LeonardoPoliti/eeg-cap-dryer/cad/cap_dryer.step

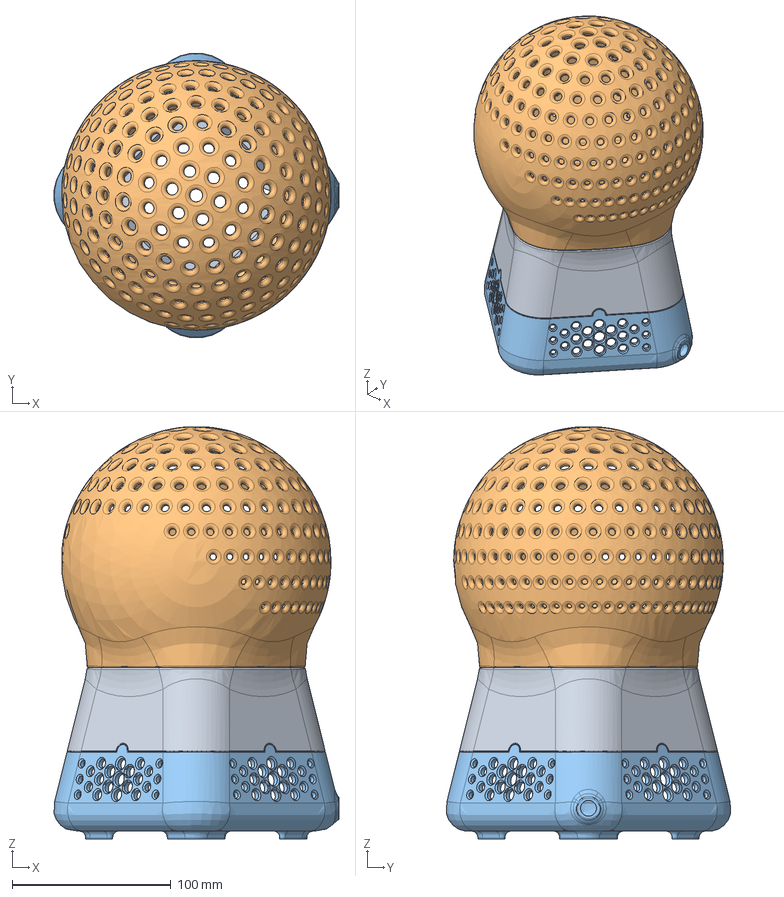
[picture p7: CAD file, 2026-10-29]
cad/cap_dryer.step
179.6 x 179.3 x 259.7 mm
