LeonardoPoliti/eeg-cap-dryer/stl/dome.stl

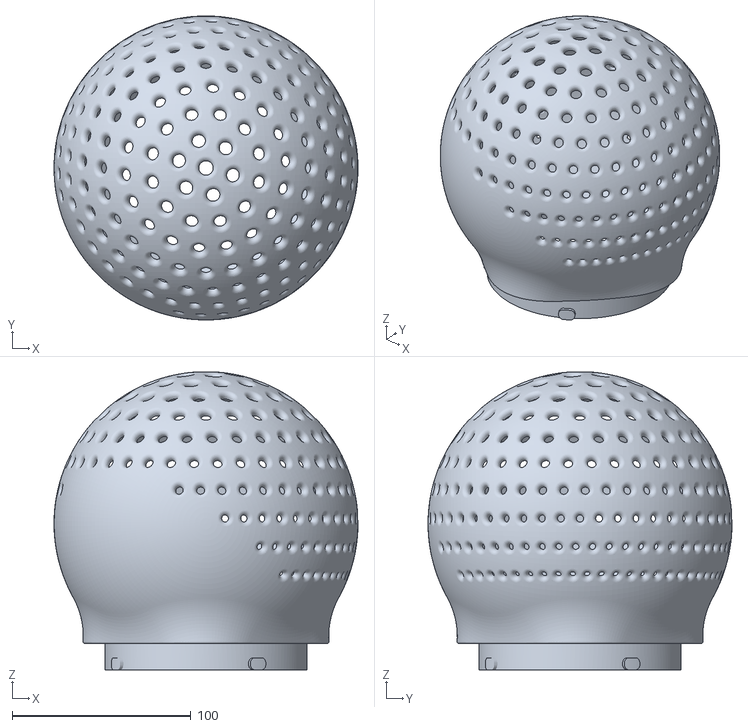
[picture p8: CAD file, 2026-10-29]
stl/dome.stl
170.0 x 170.0 x 166.5
