LeonardoPoliti/eeg-cap-dryer/stl/base.stl

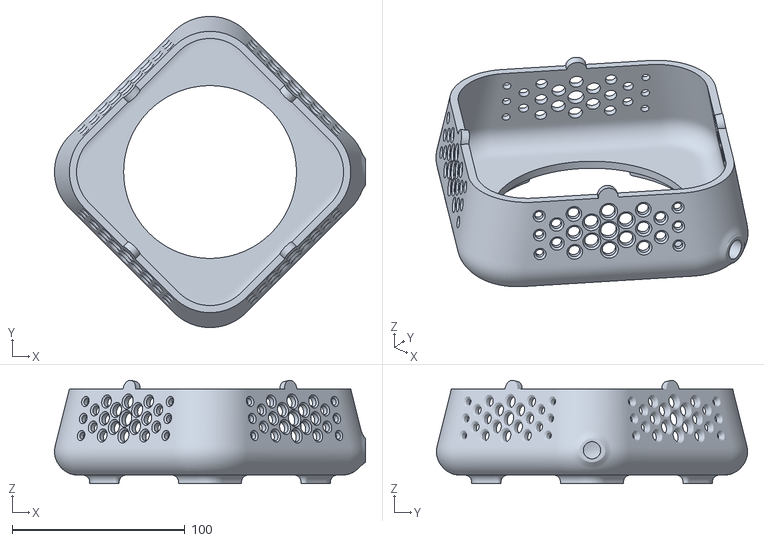
[picture p9: CAD file, 2026-10-29]
stl/base.stl
180.1 x 180.1 x 59.9
