LeonardoPoliti/eeg-cap-dryer/stl/adapter.stl

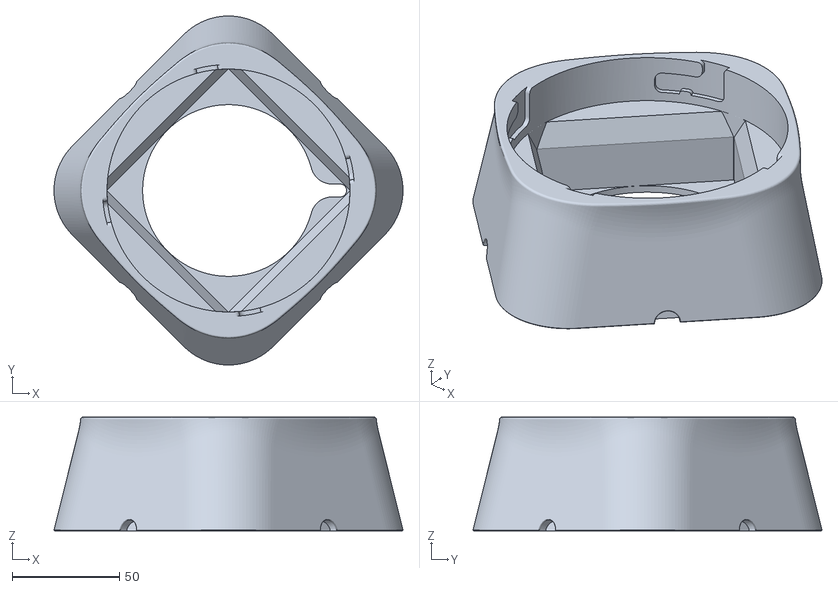
[picture p10: CAD file, 2026-10-29]
stl/adapter.stl
162.6 x 162.6 x 53.0
