LeonardoPoliti/eeg-cap-dryer/(list of files, cad)

Other CAD files:
cad/cap_dryer.3mf
